ikeji/ikejisplit/pcb/lets-split.kicad_pcb

## KiCad design pcb/lets-split.kicad_pcb (2024-03-02)

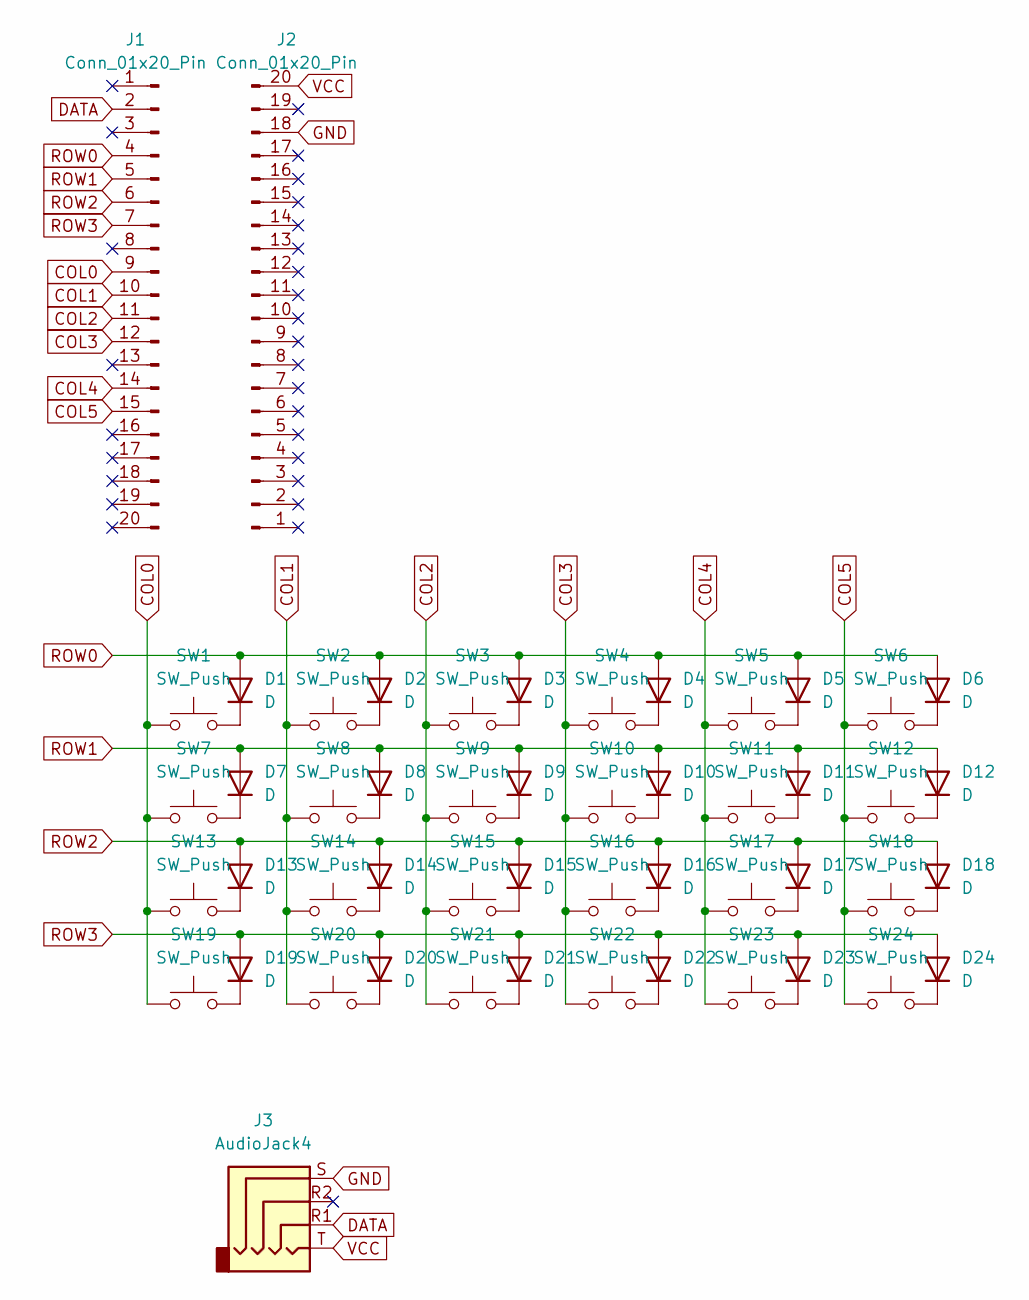
[picture p1: schematic lets-split.kicad_sch]

Parts:
D1, D2, D3, D4, D5, D6, D7, D8, D9, D10, D11, D12, D13, D14, D15, D16, D17, D18, D19, D20, D21, D22, D23, D24: D; D_DO-34_SOD68_P7.62mm_Horizontal
J1, J2: Conn_01x20_Pin; PinHeader_1x20_P2.54mm_Vertical
J3: AudioJack4; Jack_3.5mm_PJ320E_Horizontal
SW1, SW2, SW3, SW4, SW5, SW6, SW7, SW8, SW9, SW10, SW11, SW12, SW13, SW14, SW15, SW16, SW17, SW18, SW19, SW20, SW21, SW22, SW23, SW24: SW_Push; SW_Cherry_MX_1.00u_PCB

Connections:
COL0: J1.9, SW1.1, SW7.1, SW13.1, SW19.1
COL1: J1.10, SW2.1, SW8.1, SW14.1, SW20.1
COL2: J1.11, SW3.1, SW9.1, SW15.1, SW21.1
COL3: J1.12, SW4.1, SW10.1, SW16.1, SW22.1
COL4: J1.14, SW5.1, SW11.1, SW17.1, SW23.1
COL5: J1.15, SW6.1, SW12.1, SW18.1, SW24.1
DATA: J1.2, J3.R1
GND: J2.18, J3.S
unnamed: D1.1 (K), SW1.2
unnamed: D2.1 (K), SW2.2
unnamed: D3.1 (K), SW3.2
unnamed: D4.1 (K), SW4.2
unnamed: D5.1 (K), SW5.2
unnamed: D6.1 (K), SW6.2
unnamed: D7.1 (K), SW7.2
unnamed: D8.1 (K), SW8.2
unnamed: D9.1 (K), SW9.2
unnamed: D10.1 (K), SW10.2
unnamed: D11.1 (K), SW11.2
unnamed: D12.1 (K), SW12.2
unnamed: D13.1 (K), SW13.2
unnamed: D14.1 (K), SW14.2
unnamed: D15.1 (K), SW15.2
unnamed: D16.1 (K), SW16.2
unnamed: D17.1 (K), SW17.2
unnamed: D18.1 (K), SW18.2
unnamed: D19.1 (K), SW19.2
unnamed: D20.1 (K), SW20.2
unnamed: D21.1 (K), SW21.2
unnamed: D22.1 (K), SW22.2
unnamed: D23.1 (K), SW23.2
unnamed: D24.1 (K), SW24.2
ROW0: D1.2 (A), D2.2 (A), D3.2 (A), D4.2 (A), D5.2 (A), D6.2 (A), J1.4
ROW1: D7.2 (A), D8.2 (A), D9.2 (A), D10.2 (A), D11.2 (A), D12.2 (A), J1.5
ROW2: D13.2 (A), D14.2 (A), D15.2 (A), D16.2 (A), D17.2 (A), D18.2 (A), J1.6
ROW3: D19.2 (A), D20.2 (A), D21.2 (A), D22.2 (A), D23.2 (A), D24.2 (A), J1.7
VCC: J2.20, J3.T

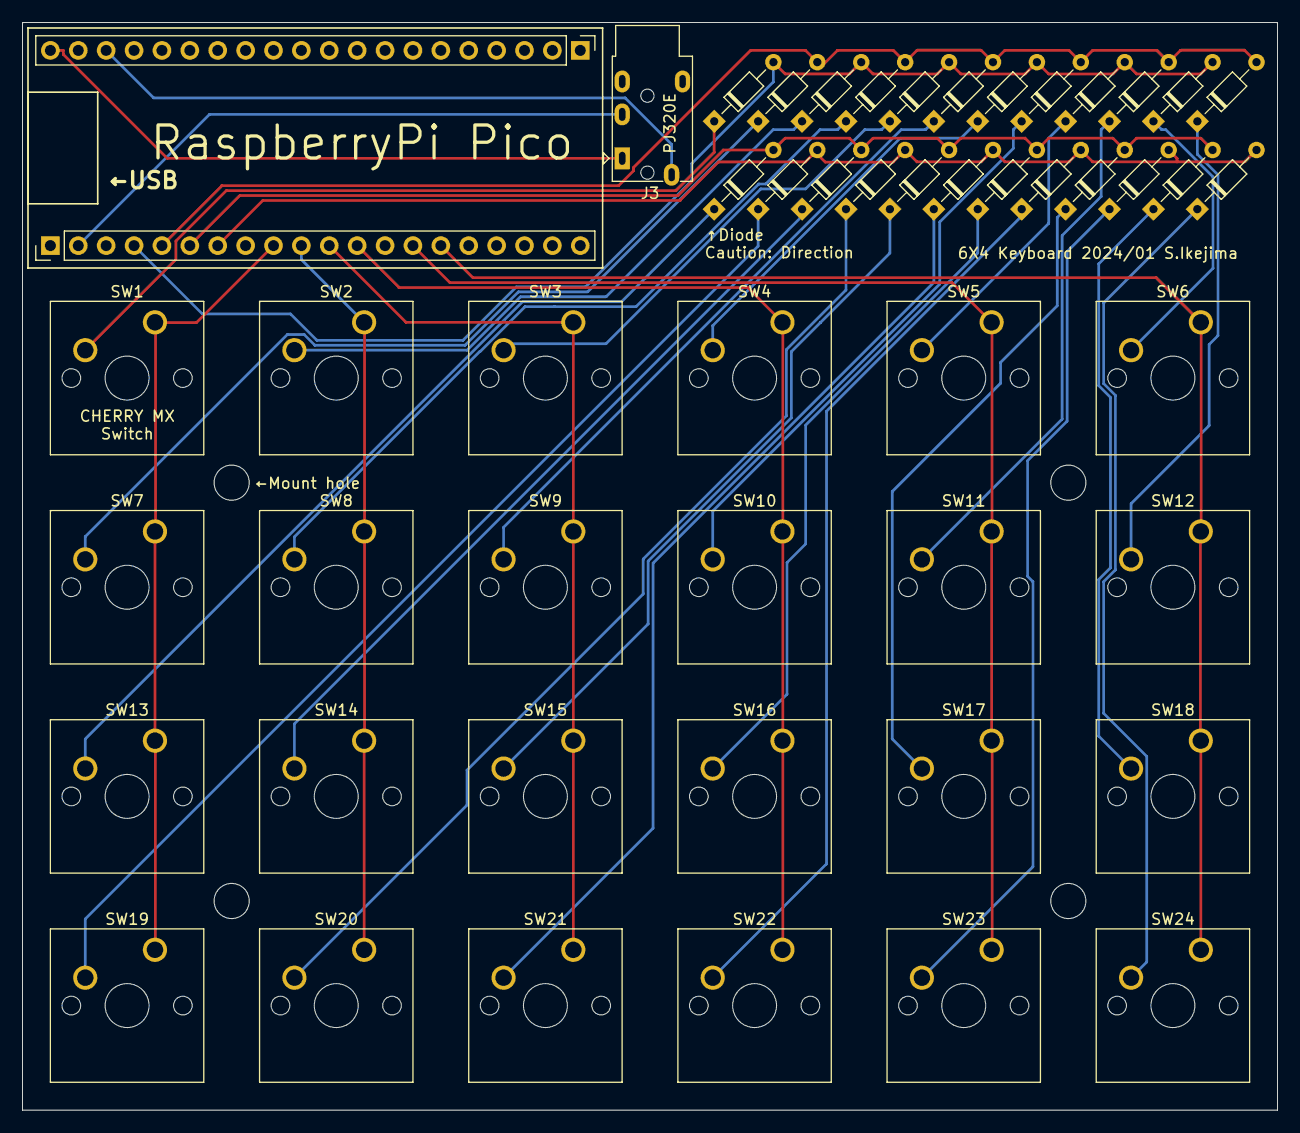
[picture p2: board lets-split.kicad_pcb from above]

Board: 2 copper layers, 114.3 x 99.1 mm, 55 parts (0 on the bottom side), 37 nets.

Other parts of the board:
REF1, REF2, REF3, REF4: MountingHole_3.2mm_M3
